Shoval-Technion/PFC-Flyback-Converter/Documentation/PFC_final_report_presentation.pptx

## PFC Flyback Converter

Final Presentation

Anat Rom · Shoval Buzaglo

Supervisor: Eric Herbelin · Spring 2026

Notes: Introduce the project and the team.

## What is a Flyback Converter?

An isolated DC-DC converter whose transformer stores energy while the switch is on and releases it to the output while it is off.

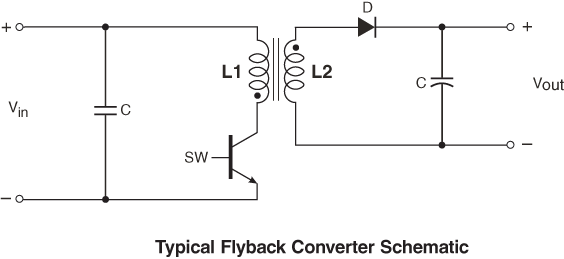
[picture p1: figure]
A Guide to Flyback Transformers | Coilcraft

Switch ON – store

The rectified line voltage sits across the primary; its current rises linearly at Vin / Lp and energy builds up in the transformer's magnetic field. The output diode is blocked.

Switch OFF – release

The stored energy transfers to the secondary, the diode conducts, and the secondary current falls linearly into the output capacitor and load.

Notes: A flyback is a buck-boost converter with a coupled inductor. The "transformer" is really an energy store: during the on-time the primary current ramps up and energy is stored in the core; when the switch opens the energy flies back to the secondary through the diode. The winding ratio (n ≈ 2.66 in our design: Lp = 90 µH, Ls = 12.7 µH) sets the voltage conversion and the transformer provides galvanic isolation. Regulation is closed across the isolation barrier with a TL431 and a 4N25 optocoupler. In a PFC flyback the input is the rectified mains, so the input voltage itself varies as a rectified sine.

## Why Do We Need PFC?

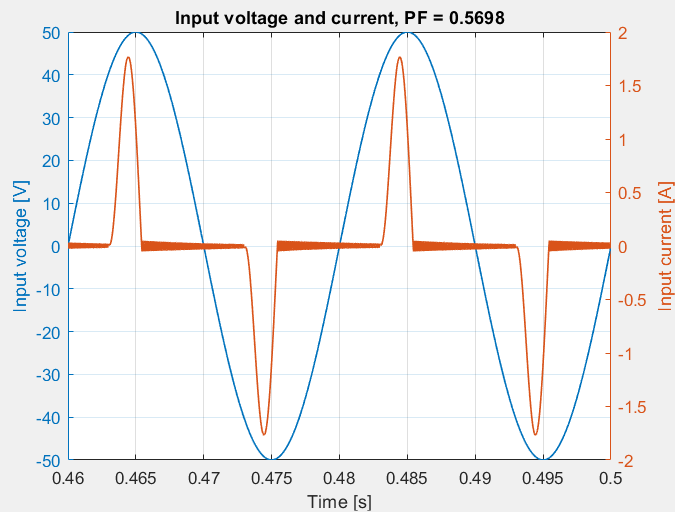
[picture p2: figure]
Input voltage and current without PFC, PF 0.5698

Without PFC: current flows only at the voltage crest (PF = 0.57)

Switching loads draw current in sharp peaks and distort the mains.

A PFC stage forces the input current to follow the input voltage.

A slow control loop (~10 Hz) averages the power demand; DC capacitors absorb the fast pulses.

Notes: Without correction, the input current flows only in narrow pulses at the voltage crest.

## Project Definition & Goals

Design and verify a 12 V / 9 W PFC Flyback converter controlled by an Arduino-class microcontroller instead of a dedicated PFC chip.

Key Performance Targets:

▸ Power Factor: ≥ 0.98 resistive, > 0.95 under varying loads

▸ Current Tracking: sinusoidal, in phase with Vin

▸ Low THD: mild increase under “violent” loads

▸ Output Stability: Vout under load steps

▸ Efficiency: measured per operating point

▸ MCU Feasibility: slow loop + one timer register

## Project Steps

1 Theoretical Study and Requirement Definition

2 Characterization of the Reference Unit (EV44010)

3 Design of Our Arduino-Controlled Converter

4 LTspice Modelling and Simulation Campaign

5 Design of the Measurement System

6 Laboratory Measurements on the Prototype

7 Data Processing and Conclusions

## Conduction Modes: CCM, DCM, BCM

CCM

Current never reaches zero

DCM

Current stays at zero before next cycle

BCM

Switch turns on exactly at zero current

+ Low peak currents

+ No reverse recovery, simple loop

+ Soft turn-on, Ipk = 2·Iavg

− Variable frequency, harder EMI filter

Reference unit

− Reverse recovery, RHP zero

− High peak and RMS currents

Our design

## Reference Unit: EV44010 Flyback

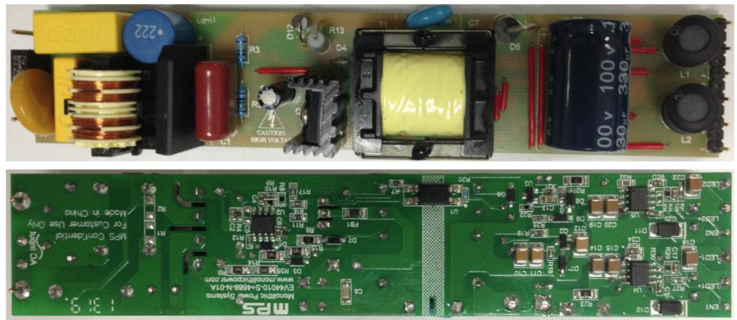
[picture p3: figure]
EV44010-S+4688-N-01A board
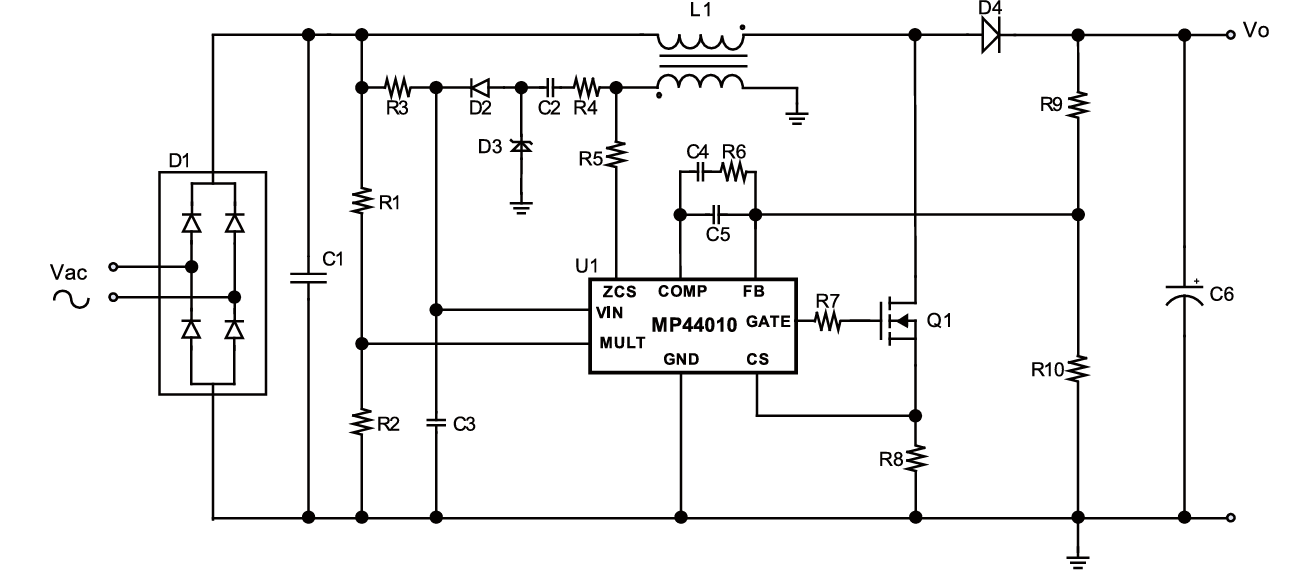
[picture p4: figure]
Simplified PFC Flyback power stage schematic

Simplified PFC Flyback power stage

EV44010-S+4688-N-01A board

## EV44010 Flyback Simulations

Reference unit, constant 0.359 A output current – load level set by the output resistance

Static loads – power factor

Load | R | R + L series | R ∥ L
100 % | 0.988 | 0.989 | 0.937
75 % | 0.992 | 0.994 | 0.933
50 % | 0.986 | 0.990 | 0.926
25 % | 0.961 | 0.982 | 0.905
η at 100 % | 85.8 % | 85.8 % | 61.5 %

Pulsed load – PF range vs. pulse rate

■ 50 → 100 % step ■ 25 → 75 % step bar = min to max PF

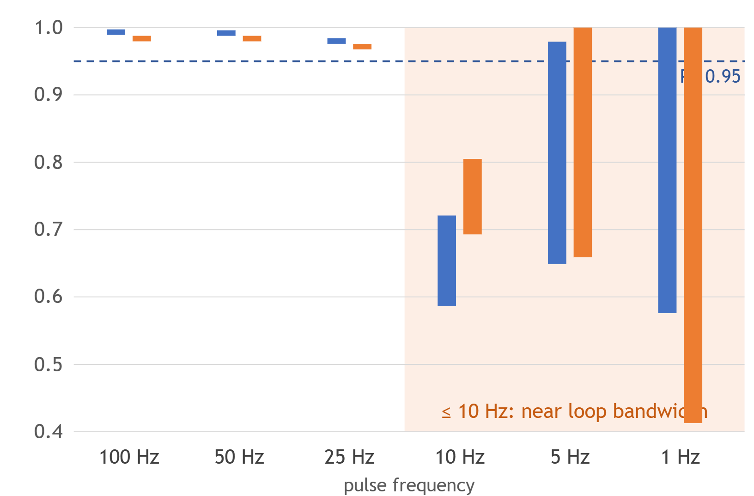
[picture p5: figure]
PF range versus pulse frequency for the EV44010: at 100, 50 and 25 Hz PF stays between 0.97 and 0.99 for both steps; at 10, 5 and 1 Hz PF swings widely, down to 0.59 and 0.41

▸ R and R + L: PF ≥ 0.96 at every load level

▸ R ∥ L: PF 0.91–0.94, efficiency only 54–61 %

Notes: Simulation results of the reference unit (EV44010). The unit drives a constant 0.359 A output current, so the load level is set by the output resistance: 122 Ω (100 %), 92 Ω (75 %), 61 Ω (50 %), 30.5 Ω (25 %). The inductive cases use L = 4.076 H with 20.4 Ω winding resistance. Static loads: with a resistor, or a resistor with the inductor in series, the PF stays at 0.96–0.99 at every level, and efficiency is about 86 % at full load, falling to 72–78 % at quarter load. With the inductor in parallel with the resistor, the PF drops to 0.91–0.94 and efficiency to 54–61 %. Pulsed load (50 % duty): at pulse rates of 25 Hz and above the PF stays between 0.97 and 0.99, and moves by no more than 0.005 inside a run. At 10 Hz and below, which is close to the ~10 Hz bandwidth of the voltage loop, the loop starts following the load and the PF swings widely: down to 0.59 (50→100 %) and 0.41 (25→75 %). The efficiencies above 100 % logged for the 10 Hz and 5 Hz pulse runs are measurement artefacts and are not shown.

## MP44010 Controller – BCM Control

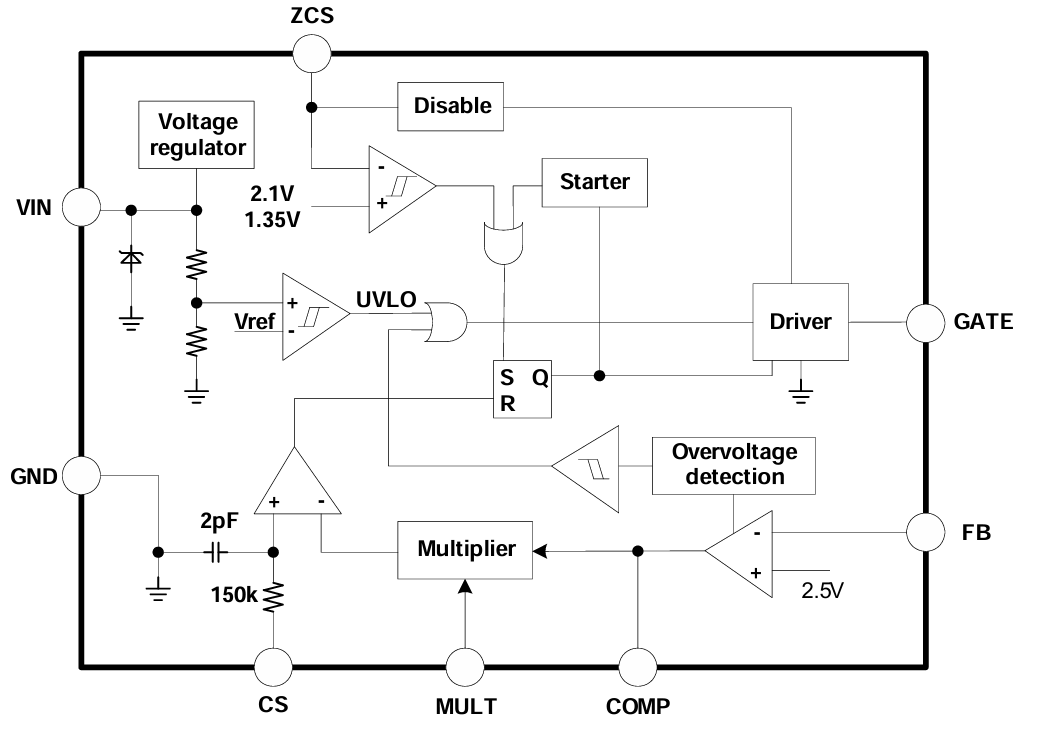
[picture p6: figure]
MP44010 controller block diagram

▸ On-time: multiplier sets a sinusoidal peak-current envelope

▸ Off-time: ZCS pin detects zero current and restarts the cycle

▸ Result: average current in phase with Vin → PF ≈ 1

▸ Protection: two-stage OVP, zero-crossing compensation, starter

## Our Design: Arduino-Controlled Flyback

Specification

Input: 35.36 V RMS (50 V peak), 50 Hz

No PFC → PFC: Four Changes

Bulk capacitor removed: Cin 125 µF → 10 nF

Output: 12 V / 9 W, isolated

Slow feedback: 100 kΩ / 150 nF, fc ≈ 10.6 Hz

Switching: fixed 100 kHz, DCM

Feedback: TL431 + 4N25 optocoupler

Control variable: on-time instead of duty cycle

Protection: cycle-by-cycle limit at 2.6 A

Controller: Arduino-class MCU

## Reference Unit vs. Our Design

We keep the core idea of the EV44010 – a slow voltage loop commanding a constant on-time – and drop the parts an MCU cannot run at switching speed.

Function | EV44010 / MP44010 (reference) | Our Arduino design
Conduction mode | BCM, variable frequency | DCM, fixed 100 kHz
Voltage loop | Error amplifier, bandwidth below ~10 Hz | Slow loop, fc ≈ 10.6 Hz (kept)
Current shaping | Multiplier sets a sinusoidal peak envelope | Constant on-time – the transformer multiplies
Cycle restart | ZCS pin on an auxiliary winding | MCU timer, every 10 µs
Peak current | Ipk = 2·Iavg | 1.95 A peak for 0.7 A output
Protection | Two-stage OVP, zero-crossing comp., starter | Cycle-by-cycle limit at 2.6 A

Notes: This slide summarises what we took from the reference unit and what we replaced. Kept: a slow voltage loop (below ~10 Hz) that commands a constant on-time. Dropped: the multiplier, the zero-current detector and the auxiliary winding, none of which a microcontroller can support at switching speed. The price is DCM's higher peak and RMS currents (1.95 A peak primary current for 0.7 A output) – acceptable at 9 W.

## Digital Constant On-Time Control

A fixed on-time makes the transformer do the multiplication: the averaged input current follows Vin(t) with no fast current loop.

⟨iin⟩ = Vin(t) · Ton² / (2 · Lp · Ts)

≈ 153 Ω

Emulated resistance Re

3.43 µs

Average on-time command

0.08 %

On-time variation over line cycle

## LTspice Models

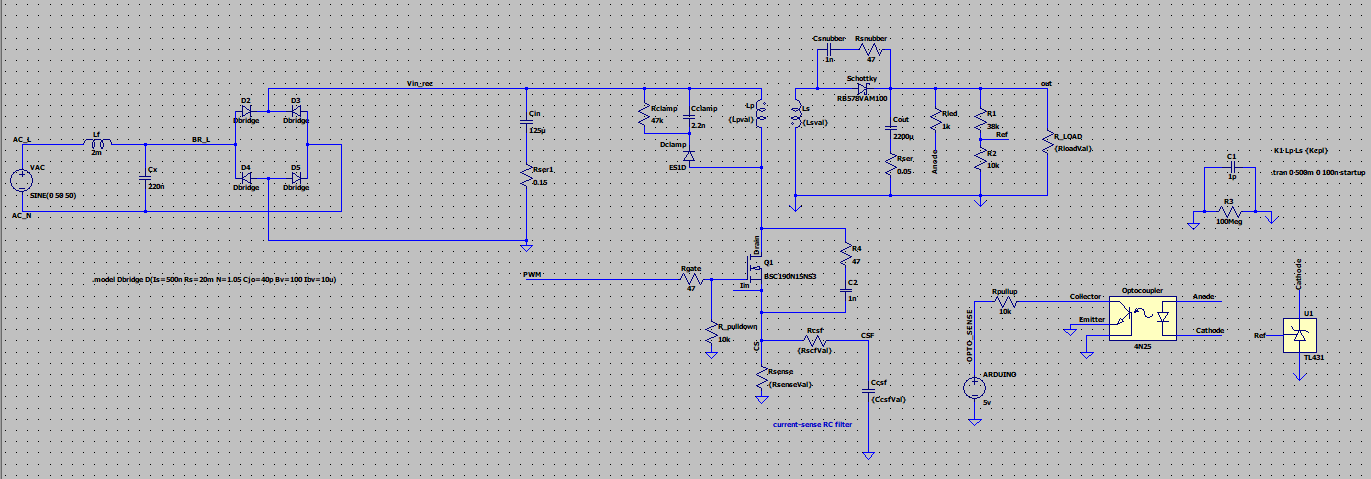
[picture p7: figure]
LTspice schematic of the converter without PFC

Without PFC

Duty-cycle PI regulator, Cin = 125 µF

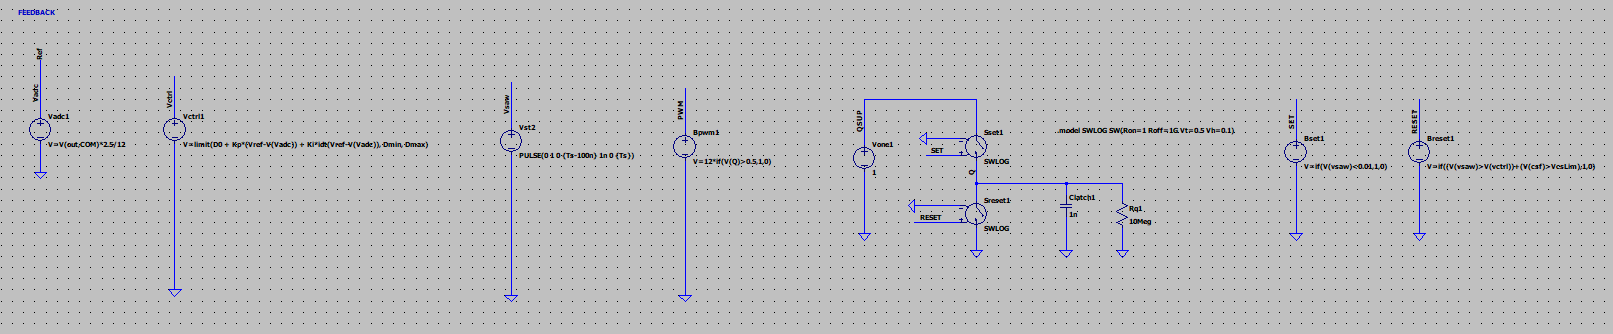
[picture p8: figure]
LTspice control block of the converter without PFC

## LTspice Models

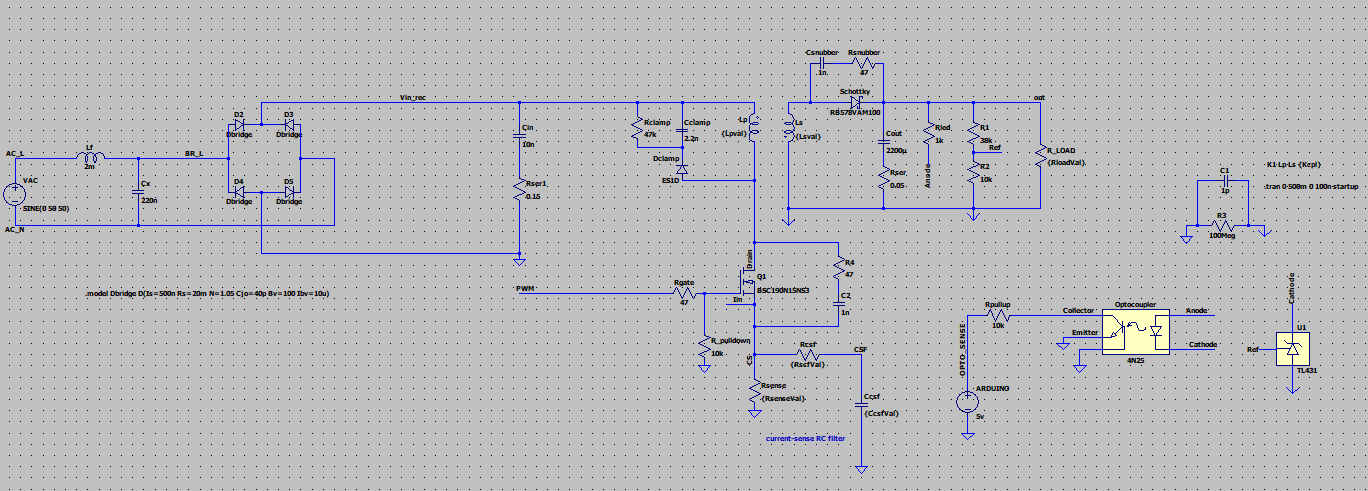
[picture p9: figure]
LTspice schematic of the converter with PFC

With PFC

Slow loop → constant Ton, Cin = 10 nF

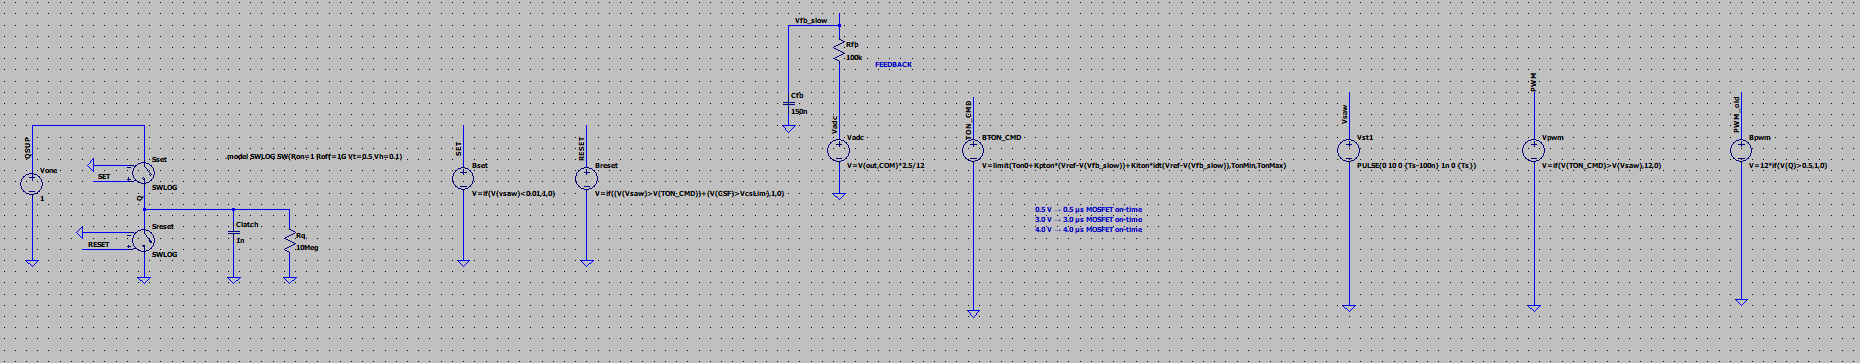
[picture p10: figure]
LTspice control block of the converter with PFC

## Switching Regime Verification – DCM

fs = 100 kHz, traces: V(pwm), I(Schottky), V(drain)

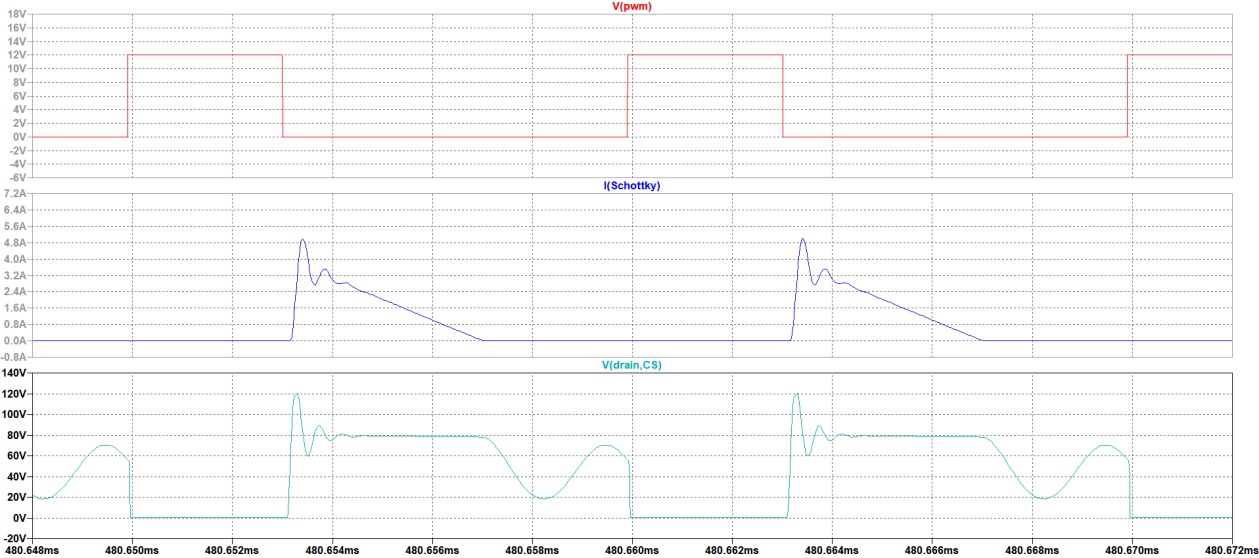
[picture p11: figure]
Switching waveforms without PFC

Dead time + free ringing, ~5 A diode peaks

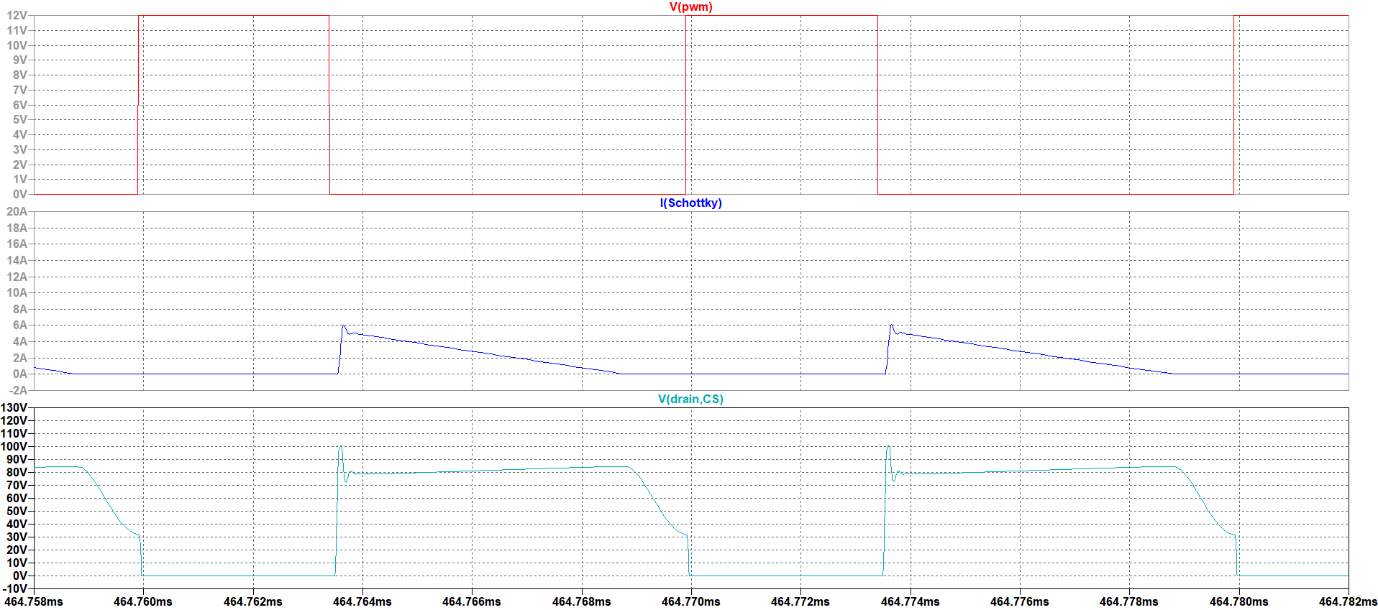
[picture p12: figure]
Switching waveforms with PFC at the line crest

Constant 3.43 µs on-time, ~5 µs demagnetisation

Without PFC

With PFC (line crest)

## Without PFC vs. With PFC

Vin = 35.36 V RMS, Vout = 12 V, resistive load ≈ 9 W, window 0.46–0.50 s

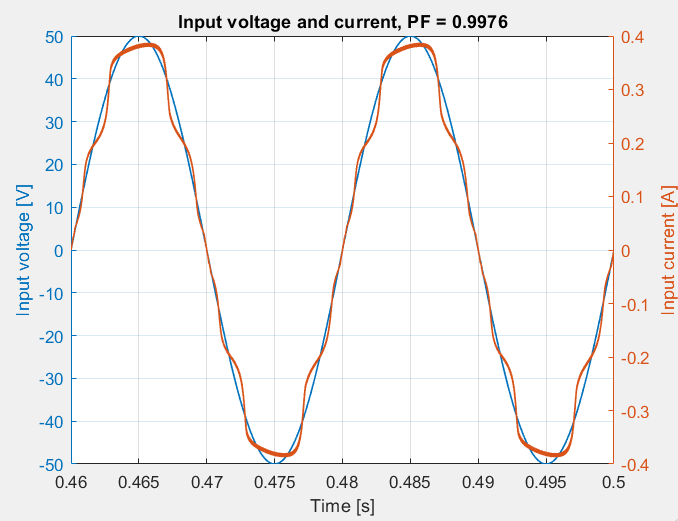
[picture p13: figure]
Input voltage and current with PFC

0.5698

139.8 %

80.1 %

0.9976

6.95 %

85.1 %

PF

THD

η

PF

THD

η

## PFC – Inductive and Capacitive Loads

Same output power (≈ 8.3 W), only the load character changes

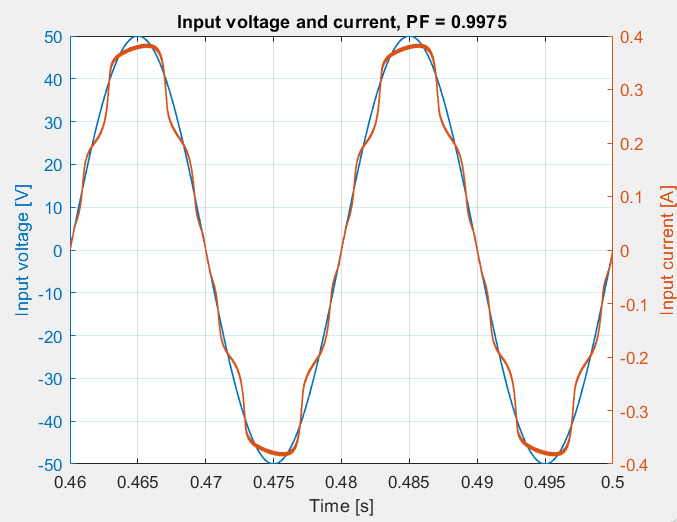
[picture p14: figure]
Inductive load: input voltage and current
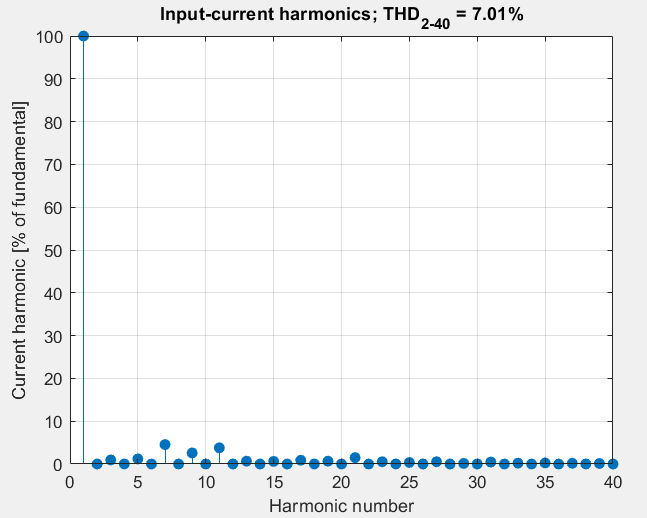
[picture p15: figure]
Inductive load: input current harmonics

Inductive

PF 0.9975

THD 7.01 %

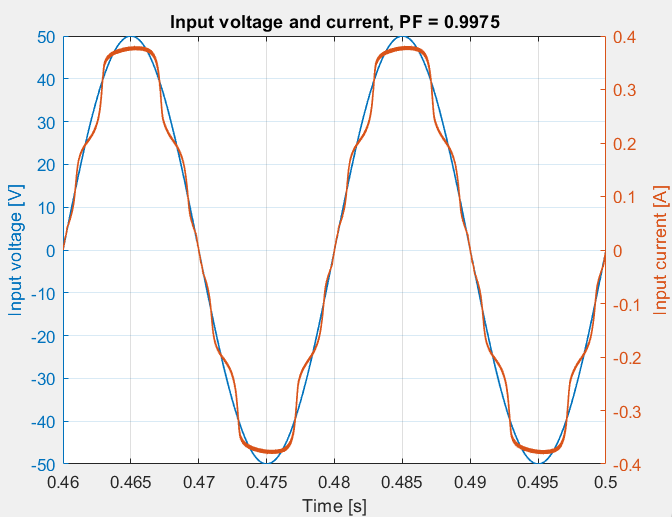
[picture p16: figure]
Capacitive load: input voltage and current
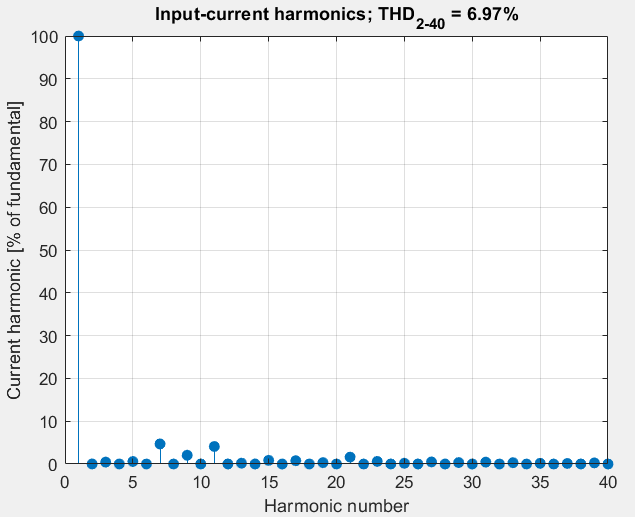
[picture p17: figure]
Capacitive load: input current harmonics

Capacitive

PF 0.9975

THD 6.97 %

## Load Character Comparison

Case | PF | THD [%] | Irms [A] | Pout [W] | η [%]
No PFC (reference) | 0.5698 | 139.77 | 0.562 | 9.08 | 80.13
PFC – Resistive | 0.9976 | 6.95 | 0.278 | 8.33 | 85.12
PFC – Inductive | 0.9975 | 7.01 | 0.275 | 8.24 | 85.07
PFC – Capacitive | 0.9975 | 6.97 | 0.275 | 8.30 | 85.59

PF varies by only 0.01 % between load types – the hypothesis holds for static loads.

## Time-Varying Load – Repeated Steps

Fixed load character, increasing step magnitude, window 0.46–0.50 s

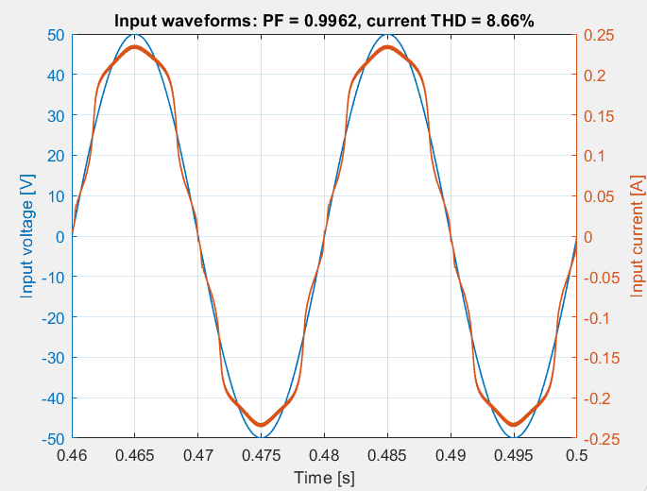
[picture p18: figure]
50 to 100 percent step
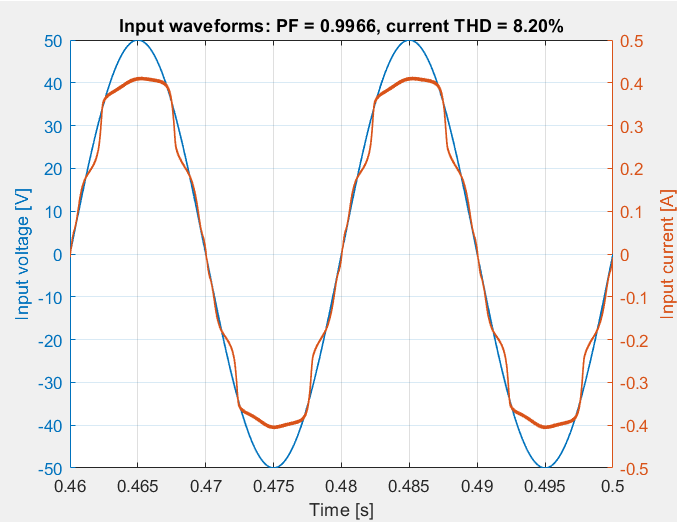
[picture p19: figure]
100 to 150 percent step
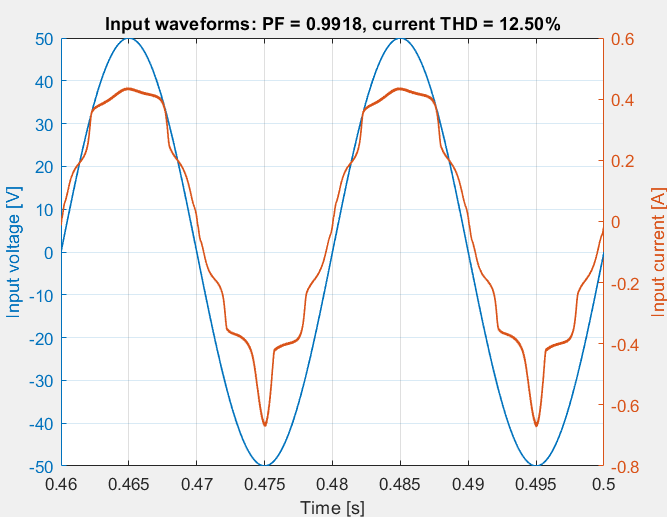
[picture p20: figure]
100 to 200 percent step
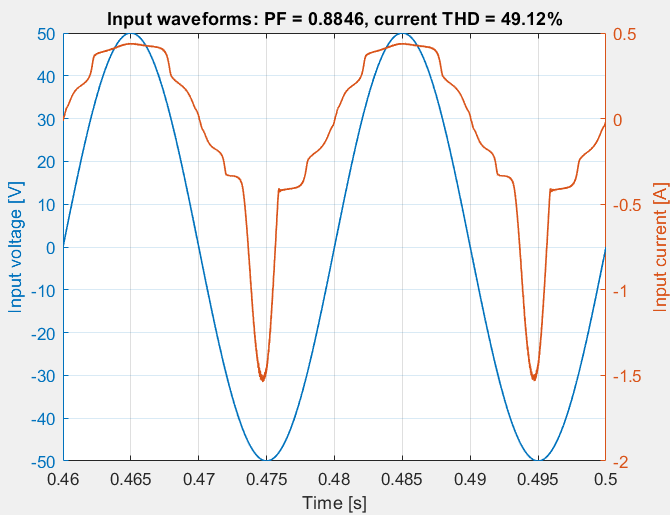
[picture p21: figure]
100 to 400 percent step

50 → 100 %

PF 0.9962

100 → 150 %

PF 0.9966

100 → 200 %

PF 0.9918

100 → 400 %

PF 0.8846

## Load Step Comparison

Load Step | PF | THD [%] | Pout [W] | Vout min / max [V] | η [%]
50 → 100 % | 0.9962 | 8.66 | 5.18 | 11.61 / 12.69 | 83.53
100 → 150 % | 0.9966 | 8.20 | 10.31 | 11.34 / 12.97 | 85.33
100 → 200 % | 0.9918 | 12.50 | 10.23 | 11.07 / 13.10 | 85.02
100 → 400 % | 0.8846 | 49.12 | 13.26 | 10.52 / 13.34 | 83.70

▸ Up to 2× step: PF > 0.99

▸ At 4×: DC-bus energy runs out – displacement factor still ≥ 0.9997

## Future Implementation Steps

▸ Build the hardware prototype and reproduce the static cases

▸ Sweep load steps between 2× and 4× to find the PF = 0.95 point

▸ Measure output-voltage recovery time after a single step

▸ Repeat the 4× case with added bulk capacitance

▸ Compare against a BCM variant with zero-current detection

## Conclusion

▸ Digital PFC on an Arduino-class MCU works: PF 0.57 → 0.998, THD 140 % → 7 %

▸ PF is independent of load character (R, L, C all ≈ 0.9975)

▸ PF depends on load dynamics – limited by DC-bus energy storage

▸ All PF loss is harmonic distortion; phase shift never exceeds 1.3°

▸ Average Vout within 0.2 % of 12 V in every case
