Shoval-Technion/PFC-Flyback-Converter/LTSpice/Flyback_12v_9W_AC_corrected.asc

ARDUINO: voltage; 5v
Bpwm1: bv; V=12*if(V(Q)>0.5,1,0)
Breset1: bv; V=if((V(vsaw)>V(vctrl))+(V(csf)>VcsLim),1,0)
Bset1: bv; V=if(V(vsaw)<0.01,1,0)
C1: cap; 1p
C2: cap; 1n
Cclamp: cap; 2.2n
Ccsf: cap; {CcsfVal}
Cin: cap; 125µ; Rser=0.15
Clatch1: cap; 1n
Cout: cap; 2200µ
Csnubber: cap; 1n
Cx: cap; 220n; Rser=0.2
D2: diode; Dbridge
D3: diode; Dbridge
D4: diode; Dbridge
D5: diode; Dbridge
Dclamp: diode; ES1D
Lf: ind; 2m; Rser=0.3
Lp: ind2; {Lpval}; Rser=1m
Ls: ind2; {Lsval}; Rser=1m
Optocoupler: 4N25
Q1: nmos; BSC190N15NS3
R1: res; 38k
R2: res; 10k
R3: res; 100Meg
R4: res; 47
R_LOAD: res; {RloadVal}
R_pulldown: res; 10k
Rclamp: res; 47k
Rcsf: res; {RscfVal}
Rgate: res; 47
Rled: res; 1k
Rpullup: res; 10k
Rq1: res; 10Meg
Rsense: res; {RsenseVal}
Rser1: res; 0.15
Rser: res; 0.05
Rsnubber: res; 47
Schottky: schottky; RB578VAM100
Sreset1: sw; SWLOG
Sset1: sw; SWLOG
U1: TL431
VAC: voltage; SINE(0 50 50)
Vadc1: bv; V=V(out,COM)*2.5/12
Vctrl1: bv; V=limit(D0 + Kp*(Vref-V(Vadc)) + Ki*idt(Vref-V(Vadc)), Dmin, Dmax)
Vone1: voltage; 1
Vst2: voltage; PULSE(0 1 0 {Ts-100n} 1n 0 {Ts})
Named nets: 0, Anode, Ref, COM, Iin, Collector, Emitter, out, Cathode, PWM, Drain, CS, CSF, AC_L, Vin_rec, OPTO_SENSE, AC_N, BR_L, Vctrl, Vsaw, Vadc, SET, RESET, QSUP, Q
K1 Lp Ls {Kcpl}
.tran 0 500m 0 100n startup
current-sense RC filter
.model Dbridge D(Is=500n Rs=20m N=1.05 Cjo=40p Bv=100 Ibv=10u)
.meas TRAN v_rms RMS V(AC_L,AC_N) FROM 460m TO 500m
.meas TRAN i_rms RMS I(VAC) FROM 460m TO 500m
.meas TRAN pin_delivered AVG -V(AC_L,AC_N)*I(VAC) FROM 460m TO 500m
 
.meas TRAN apparent_power PARAM v_rms*i_rms
.meas TRAN power_factor PARAM abs(pin_delivered/apparent_power)
 
.meas TRAN vout_avg AVG V(out,COM) FROM 460m TO 500m
.meas TRAN vout_min MIN V(out,COM) FROM 460m TO 500m
.meas TRAN vout_max MAX V(out,COM) FROM 460m TO 500m
 
.meas TRAN pout_formula AVG V(out,COM)*V(out,COM)/RloadVal FROM 460m TO 500m
.meas TRAN pout_direct AVG V(out,COM)*I(R_LOAD) FROM 460m TO 500m
 
.meas TRAN vout_start FIND V(out,COM) AT=460m
.meas TRAN vout_end FIND V(out,COM) AT=500m
.meas TRAN delta_vout PARAM vout_end-vout_start
 
.meas TRAN efficiency PARAM pout_formula/pin_delivered
.meas TRAN vcsf_max MAX V(CSF) FROM 460m TO 500m
.meas TRAN ipk_max PARAM vcsf_max/RsenseVal
.meas TRAN ilf_rms RMS I(Lf) FROM 460m TO 500m
.meas TRAN icx_rms RMS I(Cx) FROM 460m TO 500m
.meas TRAN Psense AVG I(RSENSE)*I(RSENSE)*RsenseVal FROM 460m TO 500m
.meas TRAN Plf AVG I(Lf)*I(Lf)*0.3 FROM 460m TO 500m
.meas TRAN Pcx_esr PARAM icx_rms*icx_rms*0.5
FEEDBACK
.model SWLOG SW(Ron=1 Roff=1G Vt=0.5 Vh=0.1)
.param Fs=100k
.param Ts={1/Fs}
 
.param Lpval=90u
.param Lsval=12.7u
.param Kcpl=0.98
 
.param RloadVal=16
 
.param Dmin=0.001
.param Dmax=0.45
.param D0=0.3
 
.param Kp=3
.param Ki=0.1
.param Vref=2.5
 
.param RsenseVal=0.14
 
.param RscfVal=100
.param CcsfVal=470p
 
.param Ilim=1.6
 
.param VcsLim={RsenseVal*Ilim}
