Shoval-Technion/PFC-Flyback-Converter/(commit log)

2026-10-12 Revise README for PFC Flyback Converter project
    Updated project description and details for the Arduino-oriented PFC Flyback converter, including specifications, control concept, simulation results, and future work.
2026-10-12 added matlab analysis files
    ltspice_pf_thd_efficiency.m is calculating PF, THD and efficiency for non-time-varying simulations (static load).
    Flyback_time_varying_analysis.m is calculating PF, THD and efficiency for time-varying simulations.
    flyback_DCM_waveform_check.m is used to check whether the circuit is operating in DCM.
2026-10-12 added reference files
    Added technical reference files, including datasheets and documentation for the EV44010-S+4688-N-01A reference board and its MP44010 PFC controller.
